MeteoShield/MeteoShield_Files/MeteoShield BOM V1.xlsx

 |  | www.meteoshield.com |  |  |  | MeteoShield V1 BOM
N.p.k. | DESIGNATOR | VALUE | FOOTPRINT | QUANTITY | DESCTRIPTION | CATALOG NR. | PRICE | Q*P | VAT | SUM
Capacitors
1 | C17, C18, C25, C34, C35 | 12pF | C SMD Ceramic 0402 10% | 5 |  |  |  | 0.00 € | 0% | 0.00 €
2 | C2, C9, C10, C11, C12, C16, C19, C20, C21, C22, C23, C26, C30, C32, C33 | 100nF | C SMD Ceramic 0402 10% | 15 |  |  |  | 0.00 € | 0% | 0.00 €
3 | C28 | 1uF | C SMD Ceramic 0402 10% | 1 |  |  |  | 0.00 € | 0% | 0.00 €
4 | C27 | 4.7uF | C SMD Ceramic 0402 10% | 1 |  |  |  | 0.00 € | 0% | 0.00 €
5 | C1, C7, C8, C15, C24, C29 | 10uF | C SMD Ceramic 0402 10% | 6 |  |  |  | 0.00 € | 0% | 0.00 €
 |  |  |  |  |  |  |  | 0.00 € | 0% | 0.00 €
6 | C13, C14 | 1uF | C SMD Ceramic 0603 10% | 2 |  |  |  | 0.00 € | 0% | 0.00 €
7 | C3, C4, C5, C6 | 10uF | C SMD Ceramic 0603 10% | 4 |  |  |  | 0.00 € | 0% | 0.00 €
 |  |  |  |  |  |  |  | 0.00 € | 0% | 0.00 €
8 | C31 | 0.03F | C SMD 311-VA6R | 1 | Super Capacitor |  |  | 0.00 € | 0% | 0.00 €
Resistors
9 | R26, R42 | 33R | R SMD 0402 1% | 1 |  |  |  | 0.00 € | 0% | 0.00 €
10 | R5, R6 | 330 | R SMD 0402 1% | 2 |  |  |  | 0.00 € | 0% | 0.00 €
11 | R3, R11, R12, R14, R15, R18, R19 | 1K | R SMD 0402 1% | 7 |  |  |  | 0.00 € | 0% | 0.00 €
12 | R28 | 2.2K | R SMD 0402 1% | 1 |  |  |  | 0.00 € | 0% | 0.00 €
13 | R32 | 4K | R SMD 0402 1% | 1 |  |  |  | 0.00 € | 0% | 0.00 €
14 | R1, R2, R7, R8, R21, R22, R23, R27, R29, R31, R34, R36, R37, R38, R39 | 10K | R SMD 0402 1% | 15 |  |  |  | 0.00 € | 0% | 0.00 €
15 | R24 | 68K | R SMD 0402 1% | 1 |  |  |  | 0.00 € | 0% | 0.00 €
16 | R10, R25, R33, R35, R40, R41 | 100K | R SMD 0402 1% | 6 |  |  |  | 0.00 € | 0% | 0.00 €
17 | R9 | 910K | R SMD 0402 1% | 1 |  |  |  | 0.00 € | 0% | 0.00 €
18 | R30 | 1M | R SMD 0402 1% | 1 |  |  |  | 0.00 € | 0% | 0.00 €
 |  |  |  |  |  |  |  | 0.00 € | 0% | 0.00 €
19 | R13 | 220R | R SMD 0603 1% | 1 |  |  |  | 0.00 € | 0% | 0.00 €
20 | R4, R17 | 2K | R SMD 0603 1% | 2 |  |  |  | 0.00 € | 0% | 0.00 €
21 | R16, R20 | 10K | R SMD 0603 1% | 2 |  |  |  | 0.00 € | 0% | 0.00 €
IC's
22 | U1 | NCP1117DT50G | DPAK_3 | 1 | ON SEMICONDUCTOR - NCP1117DT50G - LDO, 1.2VDO, 1A, 5V, 3DPAK |  |  | 0.00 € | 0% | 0.00 €
23 | U2 | TPS76333DBVT | SOT23-5AM | 1 | TEXAS INSTRUMENTS - TPS76333DBVT - V REG LDO 0.15A 3.3V, SMD, 76333 |  |  | 0.00 € | 0% | 0.00 €
24 | U3 | MPL3115A2 | MPL3115A2 | 1 | FREESCALE SEMICONDUCTOR - MPL3115A2 - PRESSURE SENSOR, 20-110KPA, 8LGA |  |  | 0.00 € | 0% | 0.00 €
25 | U4 | SHT21 | SHT21 | 1 | SENSIRION - SHT21 - SENSOR, HUMIDITY & TEMP, 3X3MM, 2% |  |  | 0.00 € | 0% | 0.00 €
26 | U5 | CP2102-GM | QFN_28_050 | 1 | SILICON LABORATORIES - CP2102-GM - USB-TO-UART BRIDGE, 3.6V, MLP-28 |  |  | 0.00 € | 0% | 0.00 €
27 | U6 | ISL29003IROZ-T7 | ISL29003 | 1 | INTERSIL - ISL29003IROZ-T7 - SENSOR, LIGHT TO DIGITAL, ODFN-6 |  |  | 0.00 € | 0% | 0.00 €
28 | U7 | PIC18F46K22-I/ML | QFN 44 pin 0.65pich | 1 | MICROCHIP - MCP79410-I/ST - RTCC, 12C, 1K EE, 64B SRAM,8TSSOP |  |  | 0.00 € | 0% | 0.00 €
29 | U8 | NCX2200GW | SOT353-5L | 1 | Low voltage comparator |  |  | 0.00 € | 0% | 0.00 €
30 | U9, U10 | LMV321SEG-7 | SOT353-5L | 2 | Op-Amp, Rail-To-Rail, General purpose, Low Voltage |  |  | 0.00 € | 0% | 0.00 €
31 | U11 | AT24C512C-XHD-B | TSSOP-8 pich 0.65 | 1 | Op-Amp, Rail-To-Rail, General purpose, Low Voltage |  |  | 0.00 € | 0% | 0.00 €
32 | U12 | MCP79410-I/ST | TSSOP-8 pich 0.65 | 1 | MICROCHIP - MCP79410-I/ST - RTCC, 12C, 1K EE, 64B SRAM,8TSSOP |  |  | 0.00 € | 0% | 0.00 €
Diodes
33 | VD2, VD3, VD4 | PMEG4005AEA | SOD-323 | 3 | DIODE SCHOTTKY |  |  | 0.00 € | 0% | 0.00 €
34 | VD1 | SK34SMA | D SMD DO-214AC SMA |  | TAIWAN SEMICONDUCTOR - SK34A - DIODE, SCHOTTKY, 3A, 40V, SMA |  |  | 0.00 € | 0% | 0.00 €
Transisors
35 | VT1 | FDN306P | SOT23-3L | 1 |  |  |  | 0.00 € | 0% | 0.00 €
36 | VT2, VT3 | PDTC115E | SOT416-3L | 2 |  |  |  | 0.00 € | 0% | 0.00 €
37 | VT4, VT5, VT6, VT7, VT8, VT9 | BC817 | SOT23-3L | 6 |  |  |  | 0.00 € | 0% | 0.00 €
Inductors
 |  |  |  |  |  |  |  | 0.00 € | 0% | 0.00 €
 |  |  |  |  |  |  |  | 0.00 € | 0% | 0.00 €
Connectors
38 | X1 |  | SOCKET 10 pins 2.54mm V2 | 1 |  |  |  | 0.00 € | 0% | 0.00 €
39 | X2, X3, X5 |  | SOCKET 8 pins 2.54mm V2 | 3 |  |  |  | 0.00 € | 0% | 0.00 €
40 | X4 |  | SOCKET 6 pins 2.54mm V2 | 1 |  |  |  | 0.00 € | 0% | 0.00 €
41 | X9, X10 |  | SOCKET 3 pins 2.54mm | 2 | Samtec-TSW-103-07-G-S |  |  | 0.00 € | 0% | 0.00 €
42 | X8 | MICRO USB TYPE B | USB Micro B top mount | 1 | MOLEX - 47346-0001 - MICRO USB TYPE B, RECEPTACLE, BOTTOM |  |  | 0.00 € | 0% | 0.00 €
43 | X7 |  | DC Jack 2.1mm | 1 |  |  |  | 0.00 € | 0% | 0.00 €
 |  |  |  |  |  |  |  | 0.00 € | 0% | 0.00 €
Other
44 | Mic1 | MCKPCM-60H27P-40DB-4804 | MCKPCM-60H50-40DB-4805 | 1 |  |  |  | 0.00 € | 0% | 0.00 €
 | M1 | EE891 | Module | 1 | CO2 Module 0 - 2000 ppm |  |  | 0.00 € | 0% | 0.00 €
 | OLED1 | DD-9664WE-3A | Display | 1 | DENSITRON - DD-9664WE-3A - PMOLED, 96*64, WHITE |  |  | 0.00 € | 0% | 0.00 €
45 | LED1 |  | LED SMD 0603 G | 1 |  |  |  | 0.00 € | 0% | 0.00 €
46 | JPR1, JPR2 |  |  | 2 | 2.54 |  |  | 0.00 € | 0% | 0.00 €
47 | Q2 |  | ABS13 | 1 | 32.768 kHz |  |  | 0.00 € | 0% | 0.00 €
 |  |  |  |  |  |  | TOTAL: |  | 0.00 €
