MeteoShield/MeteoShield_Files/MeteoShield EC V1.pdf

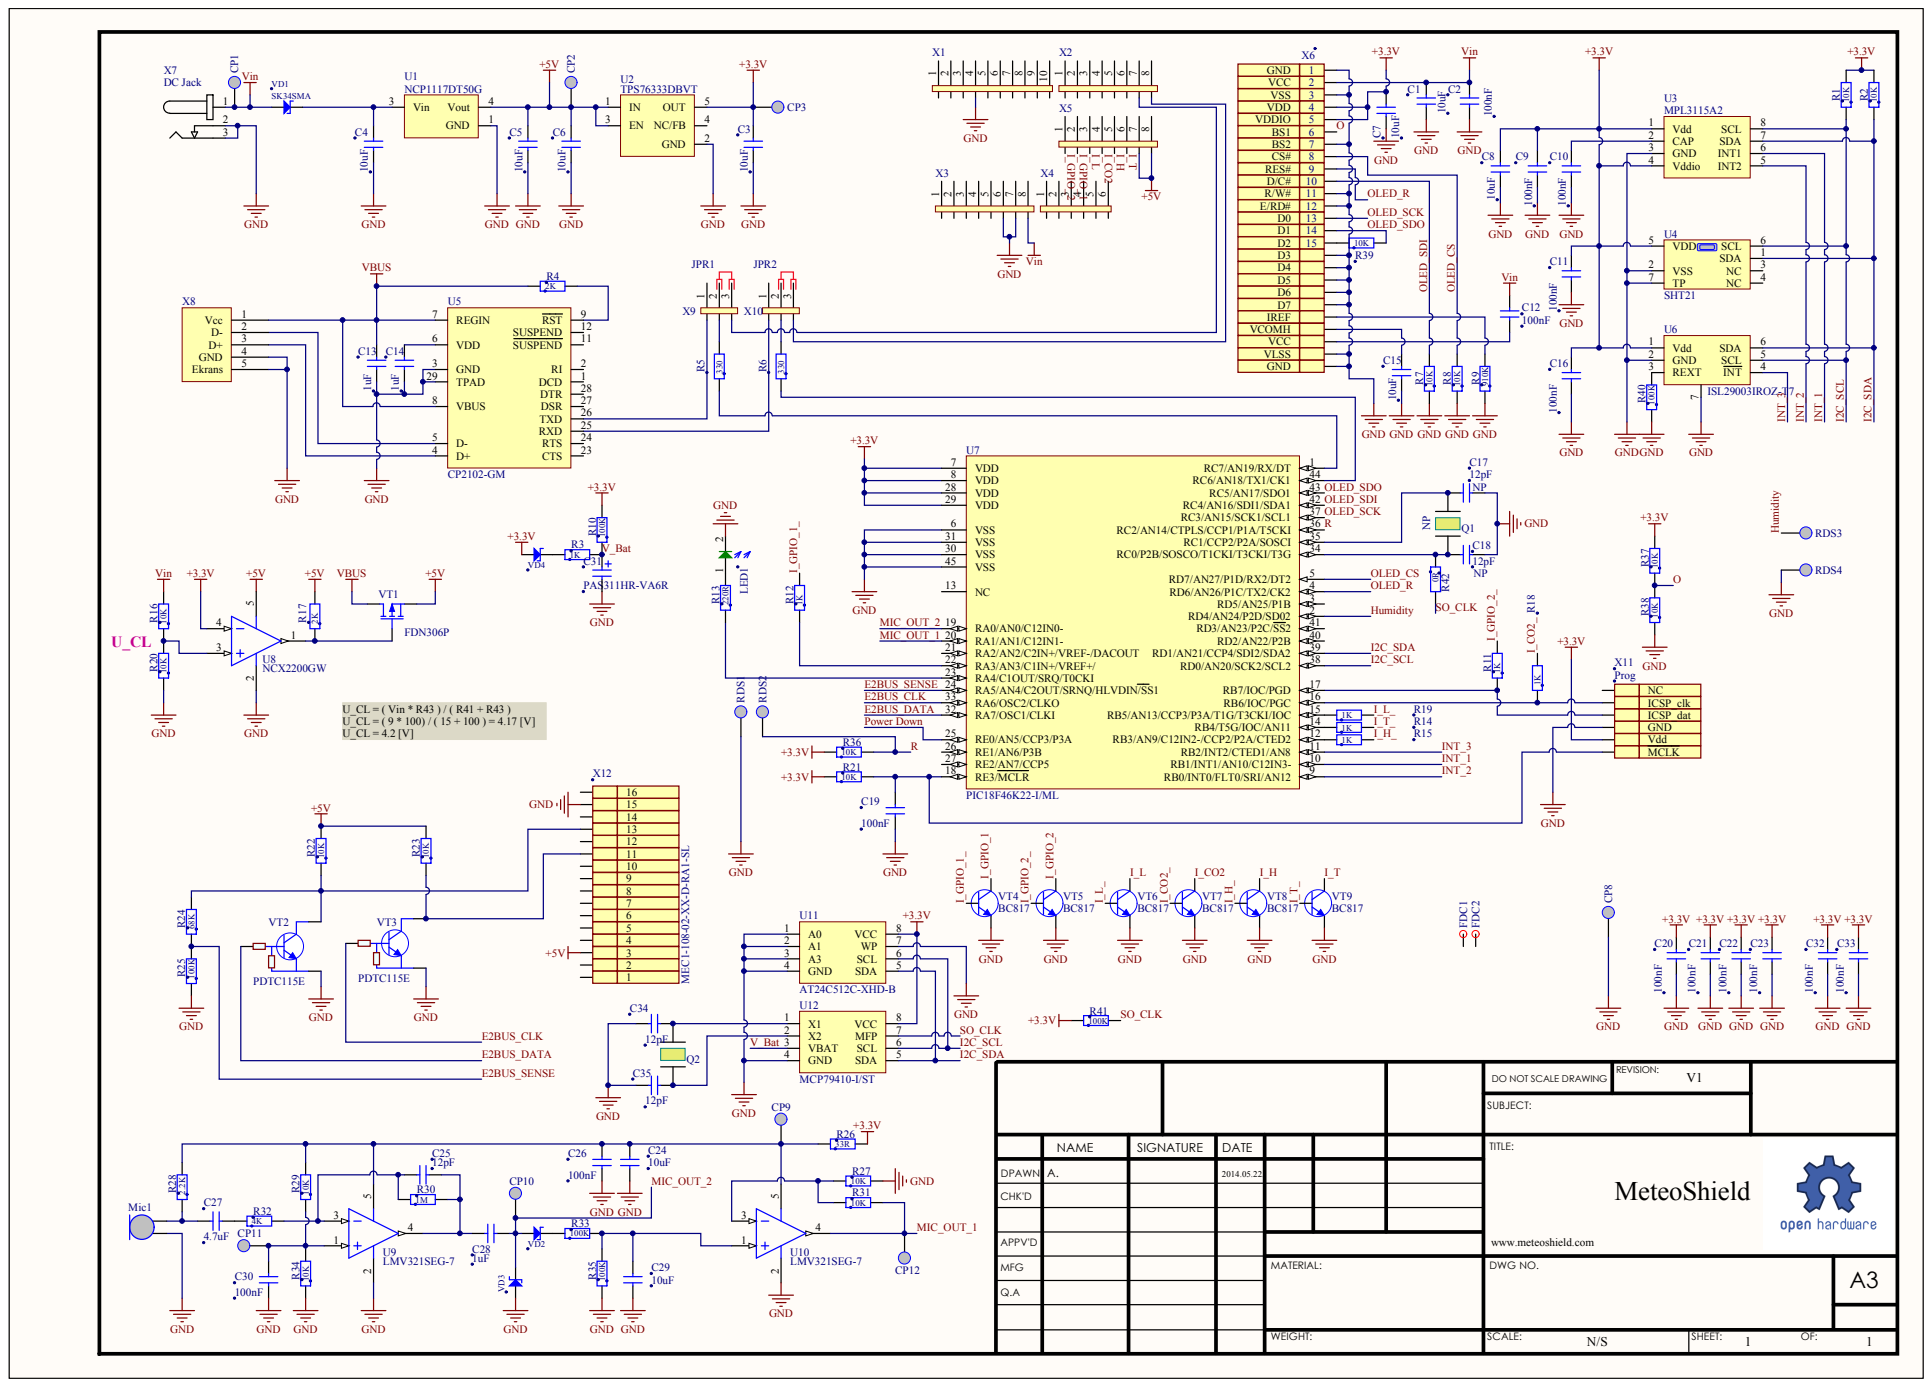
[picture p1: page 1]

GND | 1
VCC | 2

RES# | 9

R/W# | 11
E/RD# | 12

VDD 8
VDD 28 RC3/AN15/SCK1/SCL1 | OLED_SDO
VDD 29 | OLED_SDI OLED_SCK
VSS 6 | 37

VSS 31

15
14
13
12
11
10 | GND

DO NOT SCALE DRAWING

MFG | MATERIAL: | A3 DWG NO.
