MeteoShield/MeteoShield_Files/(commit log)

2014-05-24 Added -> MeteoShield BOM V1
    [MeteoShield BOM V1.xlsx]
2014-05-24 Added -> MeteoShield GERBER V1 Files
    [MeteoShield_V1.GBL, MeteoShield_V1.GBS, MeteoShield_V1.GM1, MeteoShield_V1.GTL, MeteoShield_V1.GTP, MeteoShield_V1.GTS]
